koksyn/arduino-echoboy-midi-controller/README.md

# arduino-echoboy-midi-controller
Project of USB-MIDI controller for [EchoBoy](https://www.soundtoys.com/product/echoboy/) (delay effect VST) based on [Arduino Mega 2560](https://www.arduino.cc/en/Guide/ArduinoMega2560).

## Content

1. Overview
2. Layout
3. Electrical calculations
3. Needed parts
4. PCB connections
5. Soldering
6. Testing
7. Code (ready)
8. Box preparation

## Prototype

I turned dreams into reality. No one produces such a machine, so I made it myself from scratch.

After 4 months of soldering, programming, drilling - working prototype is done.

This machine is built based on Arduino Mega 2560, a lot of expanders and AD converters.

Photos of last final steps are listed below. 

### Prototype front panel vision

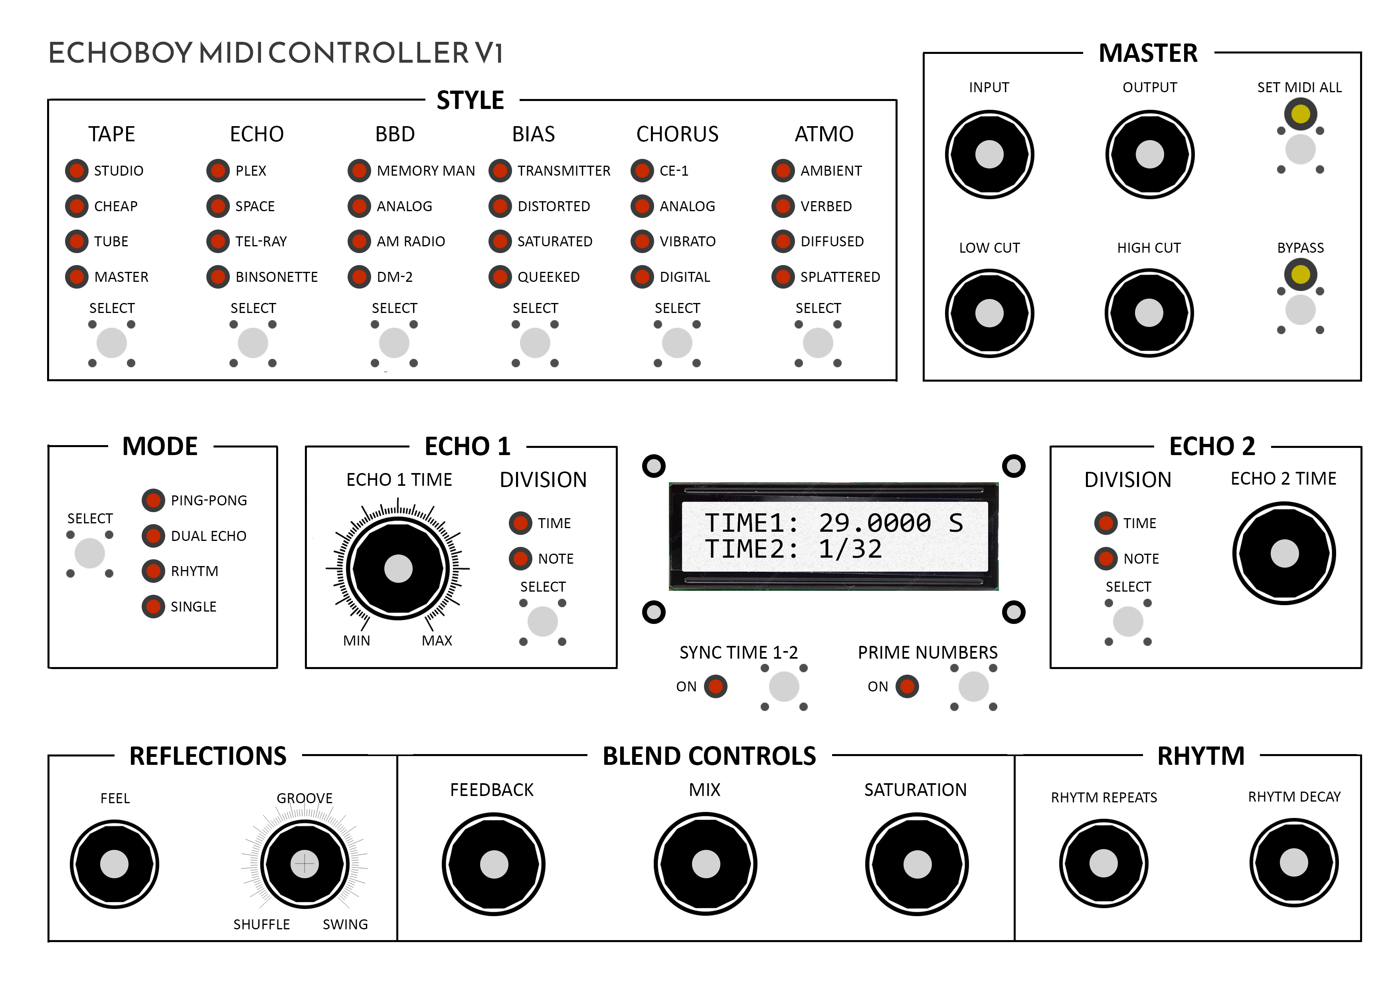
[picture p1: images/0.png]
FrontPanelVision


### Working prototype with extra features like "Sync 1-2 echo time" or "Set Midi all".

Also LCD screen inform us about last values of time/note for Echo 1 & 2.

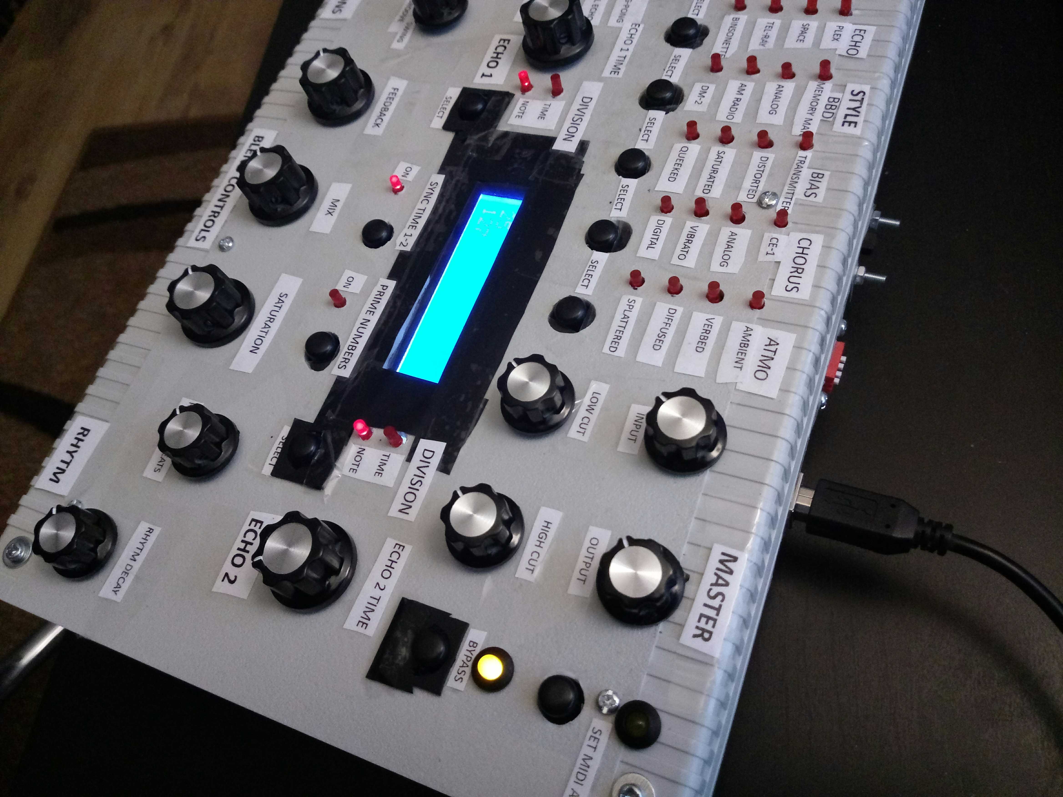
[picture p2: images/1.jpg]
FrontPanel


### Back panel

Back side with DIP 4-channel switch to choose MIDI channel. Power switch on the right side.

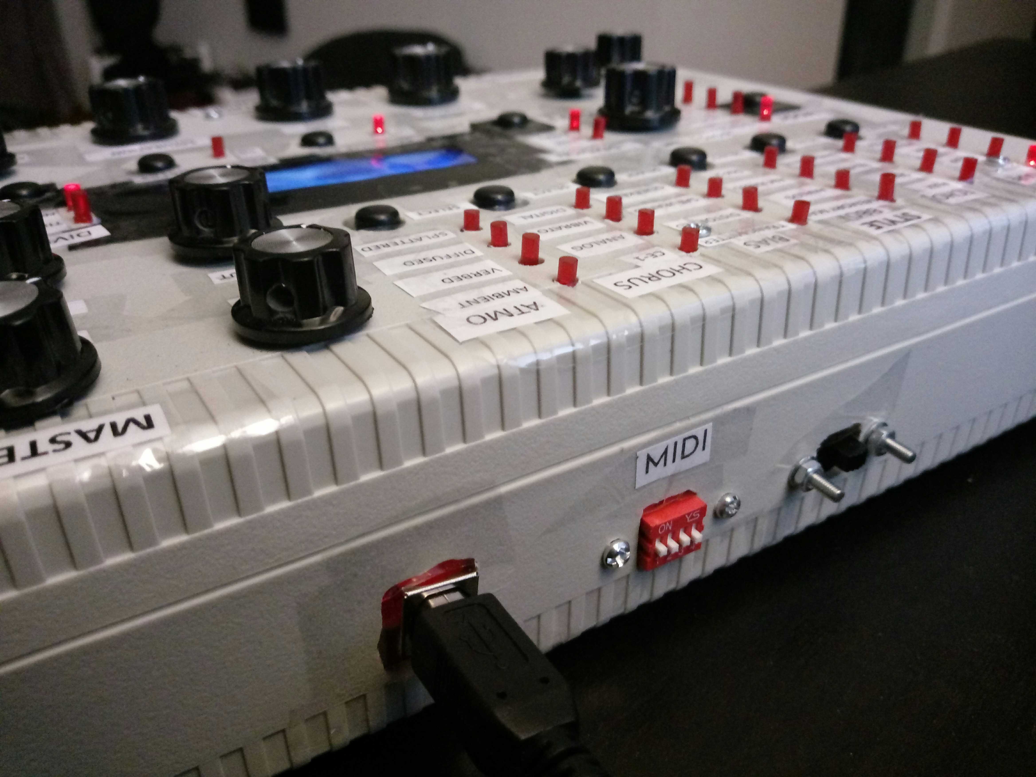
[picture p3: images/2.jpg]
BackPanel


### Mounting inside box

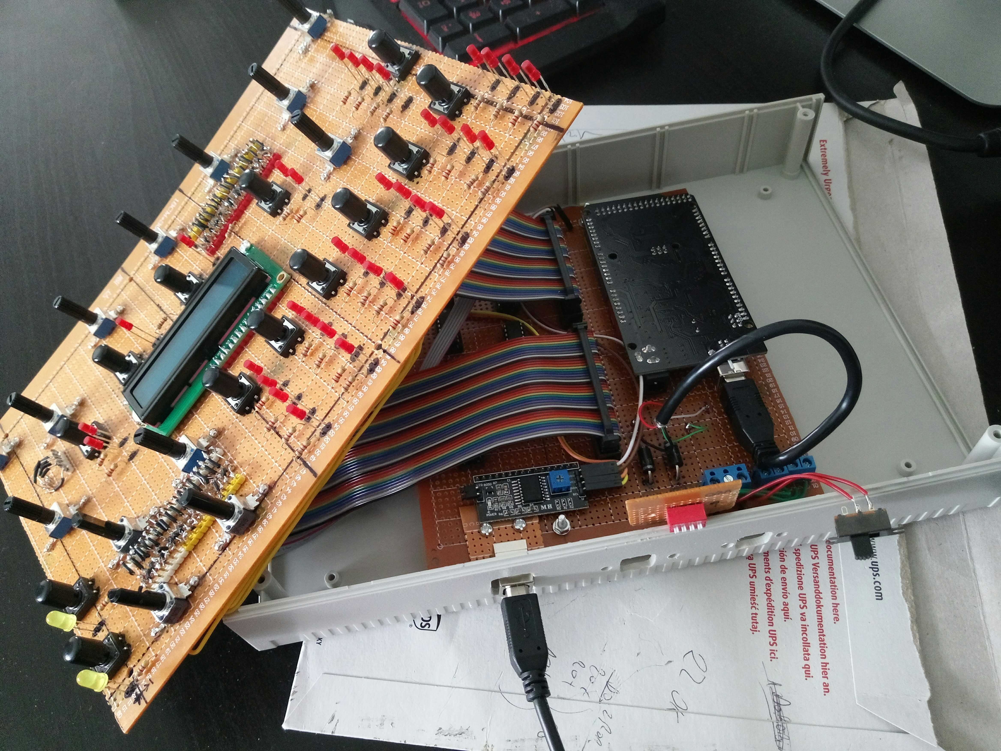
[picture p4: images/3.jpg]
MountingBox


### Soldering & testing process 

Stress memory test on Arduino Uno R3 - which fails, so then I needed Arduino Mega to handle that.

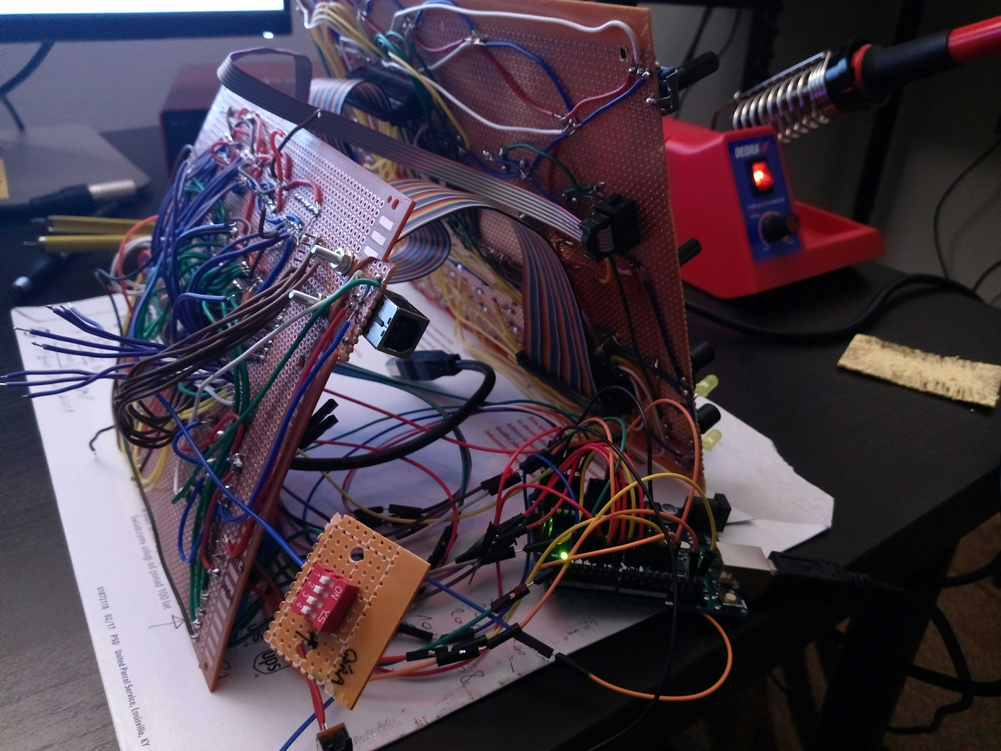
[picture p5: images/4.jpg]
MemoryTests
