koksyn/arduino-echoboy-midi-controller/(threads)

Thread 10 (2020-02-11):

Need help with wiring

4dvn, 2020-02-11:
Can you upload the schematic of pcb ? i can't manager the code :(

koksyn, 2022-03-12:
Unfortunately I've lost the schematic files, because of hard disk damage couple of years ago.
I plan in Q3-Q4 of year 2022 to come back to this project and try to recreate them from scratch (based mainly on my universal board prototype). It depends of my free time (I hope I will have some :)).
