koksyn/arduino-echoboy-midi-controller/code/StateFactory.cpp

#include "StateFactory.h"

#include "PinFactory.h"

State* StateFactory::states[STATES];

void StateFactory::initialize()
{
    // ---------- SYNC TIME ----------
    states[STATE_SYNC_TIME_DISABLED] = new State([&]() {
        // led
        PinFactory::get(PIN_LED_SYNC_TIME)->write(LOW); // off
    });

    states[STATE_SYNC_TIME_ENABLED] = new State([&]() {
        // led
        PinFactory::get(PIN_LED_SYNC_TIME)->write(HIGH); // on
    });

    states[STATE_SYNC_TIME_DISABLED]->setNextState(states[STATE_SYNC_TIME_ENABLED]);
    states[STATE_SYNC_TIME_ENABLED]->setNextState(states[STATE_SYNC_TIME_DISABLED]);

    // ---------- PRIME NUMBERS ----------
    states[STATE_PRIME_NUMBERS_DISABLED] = new State([&]() {
        // midi
        MidiProxy::sendCC(CC_PRIME_NUMBERS, uint8_t{0});

        // led
        PinFactory::get(PIN_LED_PRIME_NUMBERS)->write(LOW); // off
    });

    states[STATE_PRIME_NUMBERS_ENABLED] = new State([&]() {
        // midi
        MidiProxy::sendCC(CC_PRIME_NUMBERS, uint8_t{127});

        // led
        PinFactory::get(PIN_LED_PRIME_NUMBERS)->write(HIGH); // on
    });

    states[STATE_PRIME_NUMBERS_DISABLED]->setNextState(states[STATE_PRIME_NUMBERS_ENABLED]);
    states[STATE_PRIME_NUMBERS_ENABLED]->setNextState(states[STATE_PRIME_NUMBERS_DISABLED]);

    // ---------- ECHO 1 ----------
    states[STATE_ECHO_1_TIME] = new State([&]() {
        // midi
        MidiProxy::sendCC(CC_RHYTM_MODE, uint8_t{0});
        delay(50);
        MidiProxy::sendCC(CC_ECHO_1_DIVISION, uint8_t{0});

        // led
        PinFactory::get(PIN_LED_ECHO_1_NOTE)->write(HIGH); // off
        PinFactory::get(PIN_LED_ECHO_1_TIME)->write(LOW);
    });

    states[STATE_ECHO_1_NOTE] = new State([&]() {
        // midi
        MidiProxy::sendCC(CC_RHYTM_MODE, uint8_t{11});
        delay(50);
        MidiProxy::sendCC(CC_ECHO_1_DIVISION, uint8_t{28});

        // led
        PinFactory::get(PIN_LED_ECHO_1_NOTE)->write(LOW);
        PinFactory::get(PIN_LED_ECHO_1_TIME)->write(HIGH); // off
    });

    states[STATE_ECHO_1_TIME]->setNextState(states[STATE_ECHO_1_NOTE]);
    states[STATE_ECHO_1_NOTE]->setNextState(states[STATE_ECHO_1_TIME]);

    // ---------- ECHO 2 ----------
    states[STATE_ECHO_2_TIME] = new State([&]() {
        // midi
        MidiProxy::sendCC(CC_RHYTM_MODE, uint8_t{0});
        delay(50);
        MidiProxy::sendCC(CC_ECHO_2_DIVISION, uint8_t{0});

        // led
        PinFactory::get(PIN_LED_ECHO_2_NOTE)->write(HIGH); // off
        PinFactory::get(PIN_LED_ECHO_2_TIME)->write(LOW);
    });

    states[STATE_ECHO_2_NOTE] = new State([&]() {
        // midi
        MidiProxy::sendCC(CC_RHYTM_MODE, uint8_t{11});
        delay(50);
        MidiProxy::sendCC(CC_ECHO_2_DIVISION, uint8_t{28});

        // led
        PinFactory::get(PIN_LED_ECHO_2_NOTE)->write(LOW);
        PinFactory::get(PIN_LED_ECHO_2_TIME)->write(HIGH); // off
    });

    states[STATE_ECHO_2_TIME]->setNextState(states[STATE_ECHO_2_NOTE]);
    states[STATE_ECHO_2_NOTE]->setNextState(states[STATE_ECHO_2_TIME]);

    // ---------- MODE ----------
    states[STATE_MODE_PONG] = new State([&]() {
        // midi
        MidiProxy::sendCC(CC_MODE, uint8_t{65});

        // led
        PinFactory::get(PIN_LED_MODE_PING_PONG)->write(LOW);
        PinFactory::get(PIN_LED_MODE_DUAL)->write(HIGH); // off (for initial state - disabling light on LED)
        PinFactory::get(PIN_LED_MODE_RHYTM)->write(HIGH); // off (for initial state - disabling light on LED)
        PinFactory::get(PIN_LED_MODE_SINGLE)->write(HIGH); // off
    });

    states[STATE_MODE_DUAL] = new State([&]() {
        // midi
        MidiProxy::sendCC(CC_MODE, uint8_t{33});

        // led
        PinFactory::get(PIN_LED_MODE_DUAL)->write(LOW);
        PinFactory::get(PIN_LED_MODE_PING_PONG)->write(HIGH); // off
    });

    states[STATE_MODE_RHYTM] = new State([&]() {
        // midi
        MidiProxy::sendCC(CC_MODE, uint8_t{127});

        // led
        PinFactory::get(PIN_LED_MODE_RHYTM)->write(LOW);
        PinFactory::get(PIN_LED_MODE_DUAL)->write(HIGH); // off
    });

    states[STATE_MODE_SINGLE] = new State([&]() {
        // midi
        MidiProxy::sendCC(CC_MODE, uint8_t{0});

        // led
        PinFactory::get(PIN_LED_MODE_SINGLE)->write(LOW);
        PinFactory::get(PIN_LED_MODE_RHYTM)->write(HIGH); // off
    });

    states[STATE_MODE_PONG]->setNextState(states[STATE_MODE_DUAL]);
    states[STATE_MODE_DUAL]->setNextState(states[STATE_MODE_RHYTM]);
    states[STATE_MODE_RHYTM]->setNextState(states[STATE_MODE_SINGLE]);
    states[STATE_MODE_SINGLE]->setNextState(states[STATE_MODE_PONG]);

    // ---------- BYPASS ----------
    states[STATE_BYPASS_DISABLED] = new State([&]() {
        // midi
        MidiProxy::sendCC(CC_BYPASS, uint8_t{0});
        // led
        PinFactory::get(PIN_LED_BYPASS)->write(LOW); // off
    });

    states[STATE_BYPASS_ENABLED] = new State([&]() {
        // midi
        MidiProxy::sendCC(CC_BYPASS, uint8_t{127});
        // led
        PinFactory::get(PIN_LED_BYPASS)->write(HIGH); // on
    });

    states[STATE_BYPASS_DISABLED]->setNextState(states[STATE_BYPASS_ENABLED]);
    states[STATE_BYPASS_ENABLED]->setNextState(states[STATE_BYPASS_DISABLED]);

    // ---------- STYLE TAPE ----------
    states[STATE_STYLE_TAPE_DISABLED] = new State([&]() {
        // leds
        PinFactory::get(PIN_LED_TAPE_STUDIO)->write(HIGH); // off
        PinFactory::get(PIN_LED_TAPE_CHEAP)->write(HIGH); // off
        PinFactory::get(PIN_LED_TAPE_TUBE)->write(HIGH); // off
        PinFactory::get(PIN_LED_TAPE_MASTER)->write(HIGH); // off
    });

    states[STATE_STYLE_TAPE_STUDIO] = new State([&]() {
        // midi
        MidiProxy::sendCC(CC_STYLE, uint8_t{3});

        // leds
        PinFactory::get(PIN_LED_TAPE_STUDIO)->write(LOW);
        PinFactory::get(PIN_LED_TAPE_CHEAP)->write(HIGH); // off (for initial state - disabling light on LED)
        PinFactory::get(PIN_LED_TAPE_TUBE)->write(HIGH); // off (for initial state - disabling light on LED)
        PinFactory::get(PIN_LED_TAPE_MASTER)->write(HIGH); // off
    });

    states[STATE_STYLE_TAPE_CHEAP] = new State([&]() {
        // midi
        MidiProxy::sendCC(CC_STYLE, uint8_t{19});

        // leds
        PinFactory::get(PIN_LED_TAPE_STUDIO)->write(HIGH); // off
        PinFactory::get(PIN_LED_TAPE_CHEAP)->write(LOW);
    });

    states[STATE_STYLE_TAPE_TUBE] = new State([&]() {
        // midi
        MidiProxy::sendCC(CC_STYLE, uint8_t{15});

        // leds
        PinFactory::get(PIN_LED_TAPE_CHEAP)->write(HIGH); // off
        PinFactory::get(PIN_LED_TAPE_TUBE)->write(LOW);
    });

    states[STATE_STYLE_TAPE_MASTER] = new State([&]() {
        // midi
        MidiProxy::sendCC(CC_STYLE, uint8_t{0});

        // leds
        PinFactory::get(PIN_LED_TAPE_TUBE)->write(HIGH); // off
        PinFactory::get(PIN_LED_TAPE_MASTER)->write(LOW);
    });

    states[STATE_STYLE_TAPE_DISABLED]->setNextState(states[STATE_STYLE_TAPE_STUDIO]);
    states[STATE_STYLE_TAPE_STUDIO]->setNextState(states[STATE_STYLE_TAPE_CHEAP]);
    states[STATE_STYLE_TAPE_CHEAP]->setNextState(states[STATE_STYLE_TAPE_TUBE]);
    states[STATE_STYLE_TAPE_TUBE]->setNextState(states[STATE_STYLE_TAPE_MASTER]);
    states[STATE_STYLE_TAPE_MASTER]->setNextState(states[STATE_STYLE_TAPE_STUDIO]);

    // ---------- STYLE ECHO ----------
    states[STATE_STYLE_ECHO_DISABLED] = new State([&]() {
        // leds
        PinFactory::get(PIN_LED_ECHO_PLEX)->write(HIGH); // off
        PinFactory::get(PIN_LED_ECHO_SPACE)->write(HIGH); // off
        PinFactory::get(PIN_LED_ECHO_TEL_RAY)->write(HIGH); // off
        PinFactory::get(PIN_LED_ECHO_BINSONETTE)->write(HIGH); // off
    });

    states[STATE_STYLE_ECHO_PLEX] = new State([&]() {
        // midi
        MidiProxy::sendCC(CC_STYLE, uint8_t{7});

        // leds
        PinFactory::get(PIN_LED_ECHO_PLEX)->write(LOW);
        PinFactory::get(PIN_LED_ECHO_BINSONETTE)->write(HIGH); // off
    });

    states[STATE_STYLE_ECHO_SPACE] = new State([&]() {
        // midi
        MidiProxy::sendCC(CC_STYLE, uint8_t{11});

        // leds
        PinFactory::get(PIN_LED_ECHO_PLEX)->write(HIGH); // off
        PinFactory::get(PIN_LED_ECHO_SPACE)->write(LOW);
    });

    states[STATE_STYLE_ECHO_TEL_RAY] = new State([&]() {
        // midi
        MidiProxy::sendCC(CC_STYLE, uint8_t{31});

        // leds
        PinFactory::get(PIN_LED_ECHO_SPACE)->write(HIGH); // off
        PinFactory::get(PIN_LED_ECHO_TEL_RAY)->write(LOW);
    });

    states[STATE_STYLE_ECHO_BINSONETTE] = new State([&]() {
        // midi
        MidiProxy::sendCC(CC_STYLE, uint8_t{35});

        // leds
        PinFactory::get(PIN_LED_ECHO_TEL_RAY)->write(HIGH); // off
        PinFactory::get(PIN_LED_ECHO_BINSONETTE)->write(LOW);
    });

    states[STATE_STYLE_ECHO_DISABLED]->setNextState(states[STATE_STYLE_ECHO_PLEX]);
    states[STATE_STYLE_ECHO_PLEX]->setNextState(states[STATE_STYLE_ECHO_SPACE]);
    states[STATE_STYLE_ECHO_SPACE]->setNextState(states[STATE_STYLE_ECHO_TEL_RAY]);
    states[STATE_STYLE_ECHO_TEL_RAY]->setNextState(states[STATE_STYLE_ECHO_BINSONETTE]);
    states[STATE_STYLE_ECHO_BINSONETTE]->setNextState(states[STATE_STYLE_ECHO_PLEX]);

    // ---------- STYLE BBD ----------
    states[STATE_STYLE_BBD_DISABLED] = new State([&]() {
        // leds
        PinFactory::get(PIN_LED_BBD_MEMORY_MAN)->write(HIGH); // off
        PinFactory::get(PIN_LED_BBD_ANALOG)->write(HIGH); // off
        PinFactory::get(PIN_LED_BBD_AM_RADIO)->write(HIGH); // off
        PinFactory::get(PIN_LED_BBD_DM_2)->write(HIGH); // off
    });

    states[STATE_STYLE_BBD_MEMORY_MAN] = new State([&]() {
        // midi
        MidiProxy::sendCC(CC_STYLE, uint8_t{23});

        // leds
        PinFactory::get(PIN_LED_BBD_MEMORY_MAN)->write(LOW);
        PinFactory::get(PIN_LED_BBD_DM_2)->write(HIGH); // off
    });

    states[STATE_STYLE_BBD_ANALOG] = new State([&]() {
        // midi
        MidiProxy::sendCC(CC_STYLE, uint8_t{64});

        // leds
        PinFactory::get(PIN_LED_BBD_MEMORY_MAN)->write(HIGH); // off
        PinFactory::get(PIN_LED_BBD_ANALOG)->write(LOW);
    });

    states[STATE_STYLE_BBD_AM_RADIO] = new State([&]() {
        // midi
        MidiProxy::sendCC(CC_STYLE, uint8_t{44});

        // leds
        PinFactory::get(PIN_LED_BBD_ANALOG)->write(HIGH); // off
        PinFactory::get(PIN_LED_BBD_AM_RADIO)->write(LOW);
    });

    states[STATE_STYLE_BBD_DM_2] = new State([&]() {
        // midi
        MidiProxy::sendCC(CC_STYLE, uint8_t{27});

        // leds
        PinFactory::get(PIN_LED_BBD_AM_RADIO)->write(HIGH); // off
        PinFactory::get(PIN_LED_BBD_DM_2)->write(LOW);
    });

    states[STATE_STYLE_BBD_DISABLED]->setNextState(states[STATE_STYLE_BBD_MEMORY_MAN]);
    states[STATE_STYLE_BBD_MEMORY_MAN]->setNextState(states[STATE_STYLE_BBD_ANALOG]);
    states[STATE_STYLE_BBD_ANALOG]->setNextState(states[STATE_STYLE_BBD_AM_RADIO]);
    states[STATE_STYLE_BBD_AM_RADIO]->setNextState(states[STATE_STYLE_BBD_DM_2]);
    states[STATE_STYLE_BBD_DM_2]->setNextState(states[STATE_STYLE_BBD_MEMORY_MAN]);

    // ---------- STYLE BIAS ----------
    states[STATE_STYLE_BIAS_DISABLED] = new State([&]() {
        // leds
        PinFactory::get(PIN_LED_BIAS_TRANSMITTER)->write(HIGH); // off
        PinFactory::get(PIN_LED_BIAS_DISTORTED)->write(HIGH); // off
        PinFactory::get(PIN_LED_BIAS_SATURATED)->write(HIGH); // off
        PinFactory::get(PIN_LED_BIAS_QUEEKED)->write(HIGH); // off
    });

    states[STATE_STYLE_BIAS_TRANSMITTER] = new State([&]() {
        // midi
        MidiProxy::sendCC(CC_STYLE, uint8_t{56});

        // leds
        PinFactory::get(PIN_LED_BIAS_TRANSMITTER)->write(LOW);
        PinFactory::get(PIN_LED_BIAS_QUEEKED)->write(HIGH); // off
    });

    states[STATE_STYLE_BIAS_DISTORTED] = new State([&]() {
        // midi
        MidiProxy::sendCC(CC_STYLE, uint8_t{101});

        // leds
        PinFactory::get(PIN_LED_BIAS_TRANSMITTER)->write(HIGH); // off
        PinFactory::get(PIN_LED_BIAS_DISTORTED)->write(LOW);
    });

    states[STATE_STYLE_BIAS_SATURATED] = new State([&]() {
        // midi
        MidiProxy::sendCC(CC_STYLE, uint8_t{84});

        // leds
        PinFactory::get(PIN_LED_BIAS_DISTORTED)->write(HIGH); // off
        PinFactory::get(PIN_LED_BIAS_SATURATED)->write(LOW);
    });

    states[STATE_STYLE_BIAS_QUEEKED] = new State([&]() {
        // midi
        MidiProxy::sendCC(CC_STYLE, uint8_t{105});

        // leds
        PinFactory::get(PIN_LED_BIAS_SATURATED)->write(HIGH); // off
        PinFactory::get(PIN_LED_BIAS_QUEEKED)->write(LOW);
    });

    states[STATE_STYLE_BIAS_DISABLED]->setNextState(states[STATE_STYLE_BIAS_TRANSMITTER]);
    states[STATE_STYLE_BIAS_TRANSMITTER]->setNextState(states[STATE_STYLE_BIAS_DISTORTED]);
    states[STATE_STYLE_BIAS_DISTORTED]->setNextState(states[STATE_STYLE_BIAS_SATURATED]);
    states[STATE_STYLE_BIAS_SATURATED]->setNextState(states[STATE_STYLE_BIAS_QUEEKED]);
    states[STATE_STYLE_BIAS_QUEEKED]->setNextState(states[STATE_STYLE_BIAS_TRANSMITTER]);

    // ---------- STYLE CHORUS ----------
    states[STATE_STYLE_CHORUS_DISABLED] = new State([&]() {
        // leds
        PinFactory::get(PIN_LED_CHORUS_CE_1)->write(HIGH); // off
        PinFactory::get(PIN_LED_CHORUS_ANALOG)->write(HIGH); // off
        PinFactory::get(PIN_LED_CHORUS_VIBRATO)->write(HIGH); // off
        PinFactory::get(PIN_LED_CHORUS_DIGITAL)->write(HIGH); // off
    });

    states[STATE_STYLE_CHORUS_CE_1] = new State([&]() {
        // midi
        MidiProxy::sendCC(CC_STYLE, uint8_t{76});

        // leds
        PinFactory::get(PIN_LED_CHORUS_CE_1)->write(LOW);
        PinFactory::get(PIN_LED_CHORUS_DIGITAL)->write(HIGH); // off
    });

    states[STATE_STYLE_CHORUS_ANALOG] = new State([&]() {
        // midi
        MidiProxy::sendCC(CC_STYLE, uint8_t{72});

        // leds
        PinFactory::get(PIN_LED_CHORUS_CE_1)->write(HIGH); // off
        PinFactory::get(PIN_LED_CHORUS_ANALOG)->write(LOW);
    });

    states[STATE_STYLE_CHORUS_VIBRATO] = new State([&]() {
        // midi
        MidiProxy::sendCC(CC_STYLE, uint8_t{80});

        // leds
        PinFactory::get(PIN_LED_CHORUS_ANALOG)->write(HIGH); // off
        PinFactory::get(PIN_LED_CHORUS_VIBRATO)->write(LOW);
    });

    states[STATE_STYLE_CHORUS_DIGITAL] = new State([&]() {
        // midi
        MidiProxy::sendCC(CC_STYLE, uint8_t{68});

        // leds
        PinFactory::get(PIN_LED_CHORUS_VIBRATO)->write(HIGH); // off
        PinFactory::get(PIN_LED_CHORUS_DIGITAL)->write(LOW);
    });

    states[STATE_STYLE_CHORUS_DISABLED]->setNextState(states[STATE_STYLE_CHORUS_CE_1]);
    states[STATE_STYLE_CHORUS_CE_1]->setNextState(states[STATE_STYLE_CHORUS_ANALOG]);
    states[STATE_STYLE_CHORUS_ANALOG]->setNextState(states[STATE_STYLE_CHORUS_VIBRATO]);
    states[STATE_STYLE_CHORUS_VIBRATO]->setNextState(states[STATE_STYLE_CHORUS_DIGITAL]);
    states[STATE_STYLE_CHORUS_DIGITAL]->setNextState(states[STATE_STYLE_CHORUS_CE_1]);

    // ---------- STYLE ATMO ----------
    states[STATE_STYLE_ATMO_DISABLED] = new State([&]() {
        // leds
        PinFactory::get(PIN_LED_ATMO_AMBIENT)->write(HIGH); // off
        PinFactory::get(PIN_LED_ATMO_VERBED)->write(HIGH); // off
        PinFactory::get(PIN_LED_ATMO_DIFFUSED)->write(HIGH); // off
        PinFactory::get(PIN_LED_ATMO_SPLATTERED)->write(HIGH); // off
    });

    states[STATE_STYLE_ATMO_AMBIENT] = new State([&]() {
        // midi
        MidiProxy::sendCC(CC_STYLE, uint8_t{109});

        // leds
        PinFactory::get(PIN_LED_ATMO_AMBIENT)->write(LOW);
        PinFactory::get(PIN_LED_ATMO_SPLATTERED)->write(HIGH); // off
    });

    states[STATE_STYLE_ATMO_VERBED] = new State([&]() {
        // midi
        MidiProxy::sendCC(CC_STYLE, uint8_t{121});

        // leds
        PinFactory::get(PIN_LED_ATMO_AMBIENT)->write(HIGH); // off
        PinFactory::get(PIN_LED_ATMO_VERBED)->write(LOW);
    });

    states[STATE_STYLE_ATMO_DIFFUSED] = new State([&]() {
        // midi
        MidiProxy::sendCC(CC_STYLE, uint8_t{113});

        // leds
        PinFactory::get(PIN_LED_ATMO_VERBED)->write(HIGH); // off
        PinFactory::get(PIN_LED_ATMO_DIFFUSED)->write(LOW);
    });

    states[STATE_STYLE_ATMO_SPLATTERED] = new State([&]() {
        // midi
        MidiProxy::sendCC(CC_STYLE, uint8_t{117});

        // leds
        PinFactory::get(PIN_LED_ATMO_DIFFUSED)->write(HIGH); // off
        PinFactory::get(PIN_LED_ATMO_SPLATTERED)->write(LOW);
    });

    states[STATE_STYLE_ATMO_DISABLED]->setNextState(states[STATE_STYLE_ATMO_AMBIENT]);
    states[STATE_STYLE_ATMO_AMBIENT]->setNextState(states[STATE_STYLE_ATMO_VERBED]);
    states[STATE_STYLE_ATMO_VERBED]->setNextState(states[STATE_STYLE_ATMO_DIFFUSED]);
    states[STATE_STYLE_ATMO_DIFFUSED]->setNextState(states[STATE_STYLE_ATMO_SPLATTERED]);
    states[STATE_STYLE_ATMO_SPLATTERED]->setNextState(states[STATE_STYLE_ATMO_AMBIENT]);
}

State* StateFactory::get(byte key)
{
    return states[key];
}
