koksyn/arduino-echoboy-midi-controller/code/ArduinoAnalogPin.cpp

#include "ArduinoAnalogPin.h"

short ArduinoAnalogPin::read()
{
    return analogRead(getAddress());
}

void ArduinoAnalogPin::write(uint8_t value)
{
    // not allowed
}

void ArduinoAnalogPin::applyMode()
{
    pinMode(getAddress(), getMode());
}

void ArduinoAnalogPin::attachInterrupt(void (*userFunc)(void), uint8_t interruptMode)
{
    // not handled
}
