koksyn/arduino-echoboy-midi-controller/code/ArduinoDigitalPin.cpp

#include "ArduinoDigitalPin.h"

#include <Arduino.h>

short ArduinoDigitalPin::read()
{
    return digitalRead(getAddress());
}

void ArduinoDigitalPin::write(uint8_t value)
{
    digitalWrite(getAddress(), value);
}

void ArduinoDigitalPin::applyMode()
{
    pinMode(getAddress(), getMode());
}

void ArduinoDigitalPin::attachInterrupt(void (*userFunc)(void), uint8_t interruptMode)
{
    ::attachInterrupt(digitalPinToInterrupt(getAddress()), userFunc, interruptMode);
}
