koksyn/arduino-echoboy-midi-controller/code/LcdManager.cpp

#include "LcdManager.h"

LiquidCrystal_I2C* LcdManager::lcd = new LiquidCrystal_I2C(0x27, CHARS_PER_LINE, 2);
uint8_t LcdManager::lineIndex = 0;
const char LcdManager::whitespace = ' ';
char LcdManager::topLine[CHARS_PER_LINE];
char LcdManager::bottomLine[CHARS_PER_LINE];

void LcdManager::initialize()
{
  lcd->init();
  lcd->backlight();
}

void LcdManager::render()
{
  lcd->clear();

  if(topLine[0] != whitespace) {
    lcd->setCursor(0, 0);
    lcd->print(topLine);
  }

  if(bottomLine[0] != whitespace) {
    lcd->setCursor(0, 1);
    lcd->print(bottomLine);
  }
}

void LcdManager::fillTopByWhitespaces()
{
  topLine[0] = whitespace;
}

void LcdManager::fillBottomByWhitespaces()
{
  bottomLine[0] = whitespace;
}

void LcdManager::clearTop()
{
  fillTopByWhitespaces();
}

void LcdManager::clearBottom()
{
  fillBottomByWhitespaces();
}

void LcdManager::clearAll()
{
  fillTopByWhitespaces();
  fillBottomByWhitespaces();
  render();
}

void LcdManager::printTop(uint8_t number)
{
  itoa(number, topLine, DECIMAL);
  render();
}

void LcdManager::printBottom(uint8_t number)
{
  itoa(number, bottomLine, DECIMAL);
  render();
}
