koksyn/arduino-echoboy-midi-controller/(commit log)

2019-02-10 Defining Pin abstraction & implementation
2019-02-10 Pin Factory
2019-02-10 Interrupts in progress
2019-02-10 Interrupts in progress-notes
2019-02-10 interrupts works with button & volatile
2019-02-10 Buttons + Interruptions + LEDs + Handlers
2019-02-18 Reducing memory (#2)
    * ok, but Memory of global vars exceeded
    * Pin Factory reducing
    * Machine Factory reducing
    * State Factory reducing
    * Button Handler reducing
    * Interruption Router reducing
    * temporary disable features for testing
    * Reducing Button Handler - v2
    * Reducing Button Handler - v2
    * Lambdas in Interruption Router & Cleaning code.ino
2019-02-19 Blank machines (#5)
    * Prime Numbers machine & states
    * Blank machines & states
    * Handling buttons
2019-02-19 Leds manipulation (#6)
2019-03-10 Attaching real pins & enable everything for tests
2019-03-10 reverting extra virtual methods (arduino wont work with them)
    [ArduinoAnalogPin.cpp, ArduinoAnalogPin.h, ArduinoDigitalPin.cpp, ArduinoDigitalPin.h, ButtonHandler.cpp, Mcp3008Pin.cpp, Mcp3008Pin.h, Pcf8574Pin.cpp]
2019-03-10 revert states according to connections
    [StateFactory.cpp]
2019-03-10 fixing - first enable PCF's and then create states
    [StateFactory.cpp, code.ino]
2019-03-10 test buttons
2019-03-10 deleting DIP MIDI 4 BUTTON - to give extra pin to Receiving Interruptions from second PCF8574
2019-03-11 fixes for button handling
    [ButtonHandler.cpp, StateFactory.cpp, code.ino]
2019-03-12 lcd + checks + states fix - All systems working finally
    [PinFactory.cpp, StateFactory.h, code.ino]
2019-03-13 fight with interruptions and LCD issue
    [InterruptionRouter.cpp, LcdManager.cpp, LcdManager.h, code.ino]
2019-03-15 interruptions on Arduino MEGA 2560 & reducing noise from sensors
    [InterruptionRouter.cpp, KnobManager.cpp, KnobManager.h, LcdManager.cpp, LcdManager.h, PinFactory.cpp, code.ino]
2019-03-16 Reducing electrical noise on Knobs
    [ArduinoAnalogPin.cpp, ArduinoAnalogPin.h, ArduinoDigitalPin.cpp, ArduinoDigitalPin.h, KnobManager.cpp, KnobManager.h, LcdManager.cpp, LcdManager.h]
2019-03-16 Correction on analog readings
    [code.ino]
2019-03-16 Fix MIDI Serial Boud Rate
    [MidiProxy.cpp, code.ino]
2019-03-16 fix missing static phrase
    [KnobManager.h]
2019-03-16 changing pin numbers after re-soldering (Arduino Uno R3 -> Arduino Mega 2560)
2019-04-05 fixing proper midi values
    [StateFactory.cpp]
2019-04-07 slowing down transfer rate to reduce communication errors
    [KnobManager.cpp, StateFactory.cpp]
